RedPetroleum/openGBW/3D/Mignon MCI/Gabel.stl

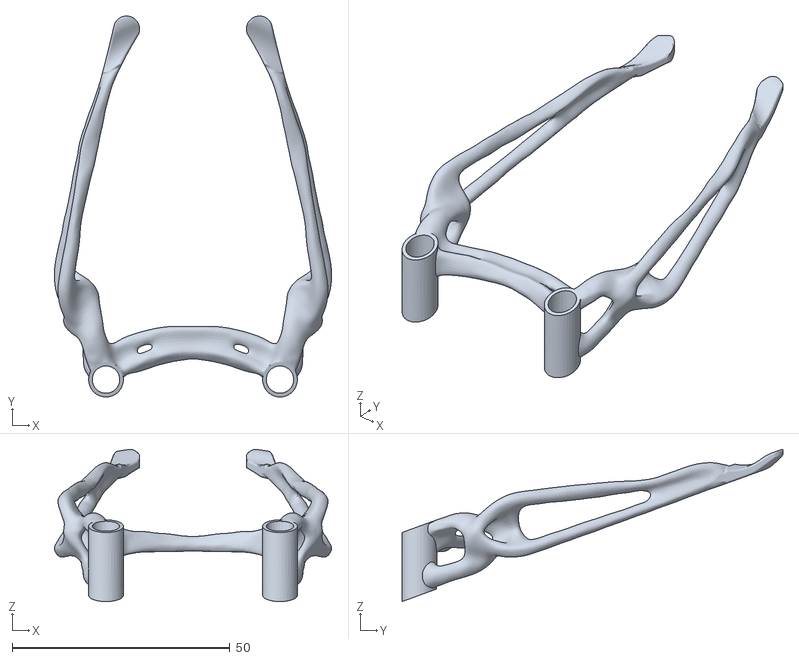
[picture p9: CAD file, 2026-09-14]
3D/Mignon MCI/Gabel.stl
63.7 x 87.6 x 35.0
