RedPetroleum/openGBW/3D/Mignon MCI/Waage_Display_Case.stl

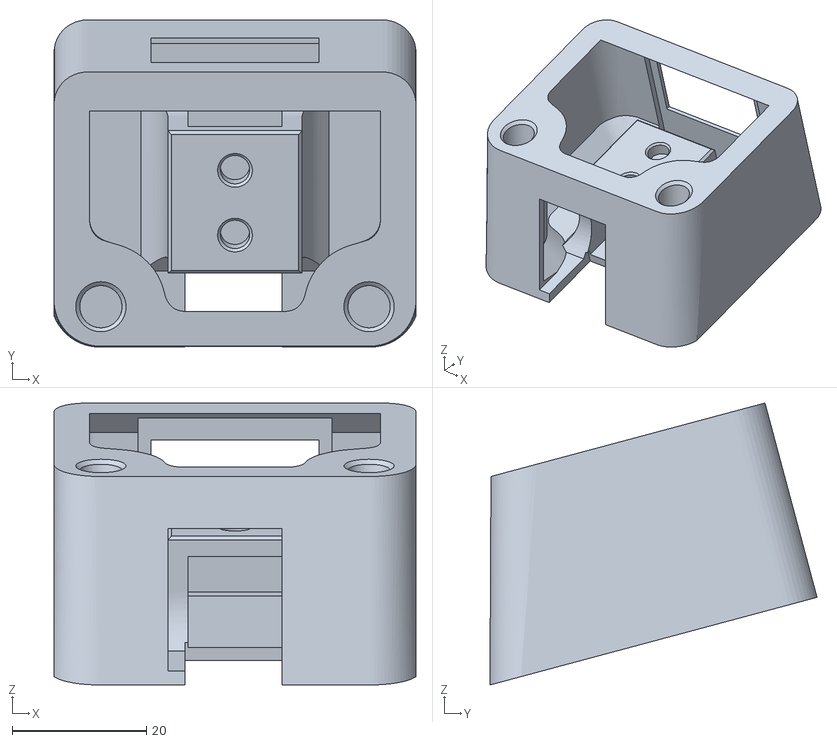
[picture p10: CAD file, 2026-09-14]
3D/Mignon MCI/Waage_Display_Case.stl
54.0 x 48.8 x 42.1
