RedPetroleum/openGBW/3D/Mignon MCI/Halter_oben.stl

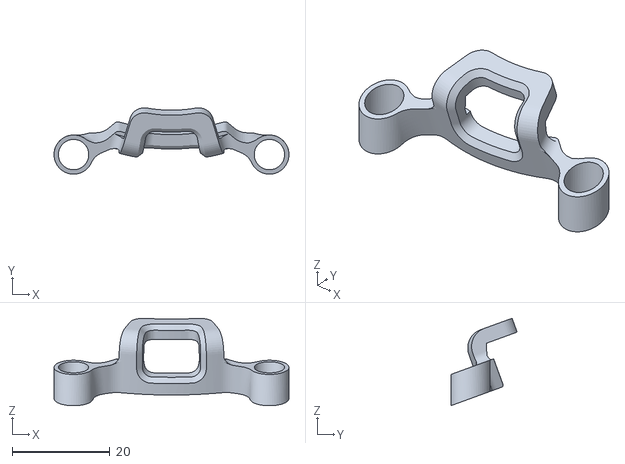
[picture p11: CAD file, 2026-09-14]
3D/Mignon MCI/Halter_oben.stl
48.0 x 13.5 x 17.9
