RedPetroleum/openGBW/3D/Mignon MCI/MCI_Stand.stl

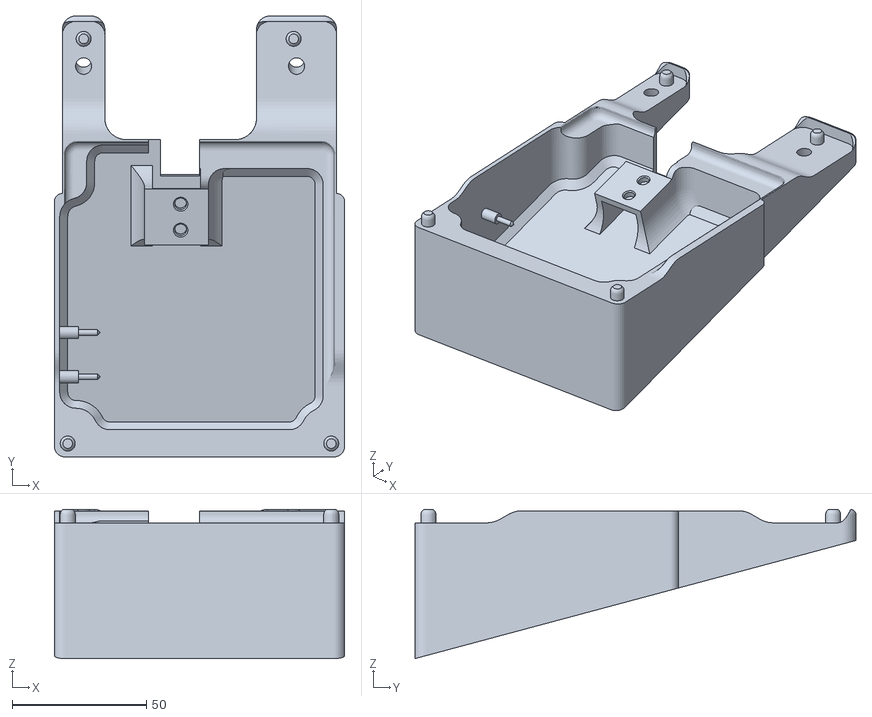
[picture p12: CAD file, 2026-09-14]
3D/Mignon MCI/MCI_Stand.stl
108.0 x 164.0 x 55.5
