RedPetroleum/openGBW/3D/Mignon MCI/Wood_plate.stl

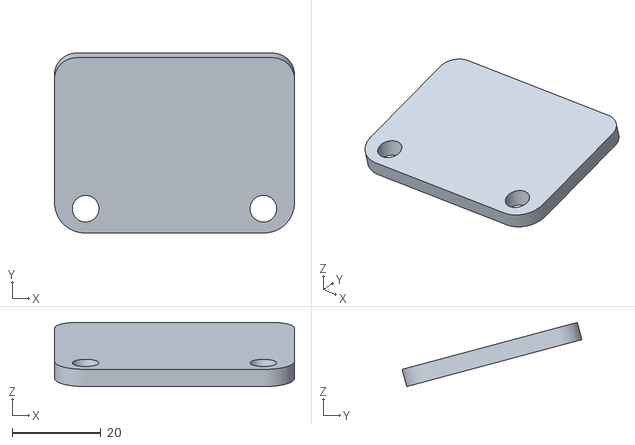
[picture p13: CAD file, 2026-09-14]
3D/Mignon MCI/Wood_plate.stl
54.0 x 40.5 x 14.4
