RedPetroleum/openGBW/src/games/doom_data.hpp

#pragma once

#include <stdint.h>

// Sprites, font and level of Doom, only included by doom.cpp
//
// Taken from doom-nano by daveruiz (https://github.com/daveruiz/doom-nano, commit 2346404):
// the AVR specific PROGMEM storage removed, the font and level macros renamed. In the level one of the two locked
// doors of the room with the key on the left is a normal door, otherwise the last key could be spent on it.
// Bitmaps have one bit per pixel, the highest bit is the leftmost pixel.

#define DOOM_LEVEL_WIDTH_BASE 6
#define DOOM_LEVEL_WIDTH (1 << DOOM_LEVEL_WIDTH_BASE)
#define DOOM_LEVEL_HEIGHT 57
#define DOOM_LEVEL_BYTES DOOM_LEVEL_WIDTH / 2 * DOOM_LEVEL_HEIGHT

#define FONT_BYTES_PER_ROW   24  // in bytes
#define FONT_ROWS  6
#define FONT_CHAR_MAP         " 0123456789ABCDEFGHIJKLMNOPQRSTUVWXYZ.,-_(){}[]#"
#define FONT_CHAR_WIDTH       4
#define FONT_CHAR_HEIGHT      6
const static uint8_t bmp_font[] = {
  0x00, 0x00, 0x00, 0x00, 0x00, 0x00, 0x00, 0x00, 0x00, 0x00, 0x00, 0x00, 0x00, 0x00, 0x00, 0x00, 0x00, 0x00, 0x00, 0x00, 0x00, 0x01, 0x80, 0x00,
  0x06, 0x26, 0x69, 0xf6, 0xf6, 0x66, 0xe6, 0xef, 0xf6, 0x92, 0x19, 0x89, 0x96, 0xe6, 0xe6, 0xe9, 0x99, 0x99, 0xf0, 0x00, 0x02, 0x41, 0x83, 0xcf,
  0x09, 0x29, 0x99, 0x88, 0x19, 0x99, 0x99, 0x98, 0x88, 0x92, 0x1a, 0x8f, 0xd9, 0x99, 0x98, 0x49, 0x99, 0x99, 0x10, 0x00, 0x04, 0x27, 0xe5, 0x6f,
  0x09, 0x22, 0x2f, 0xee, 0x16, 0x7f, 0xe8, 0x9e, 0xe8, 0xf2, 0x1c, 0x89, 0xb9, 0xe9, 0xe6, 0x49, 0x99, 0x66, 0x60, 0x06, 0x04, 0x27, 0xe7, 0xef,
  0x09, 0x24, 0x91, 0x19, 0x19, 0x19, 0x99, 0x98, 0x89, 0x92, 0x9a, 0x89, 0x99, 0x8b, 0x91, 0x49, 0x6f, 0x96, 0x80, 0x20, 0x04, 0x21, 0x87, 0xef,
  0x06, 0x7f, 0x61, 0xe6, 0x16, 0x69, 0xe6, 0xef, 0x86, 0x92, 0x69, 0xf9, 0x96, 0x87, 0x9e, 0x46, 0x69, 0x96, 0xf4, 0x40, 0xf2, 0x41, 0x80, 0xe0,
};

#define BMP_LOGO_WIDTH  72
#define BMP_LOGO_HEIGHT 47
const static uint8_t bmp_logo_bits[] = {
  0x00, 0x00, 0x00, 0x00, 0x00, 0x00, 0x00, 0x00, 0x00,
  0x40, 0x08, 0x00, 0x01, 0x04, 0x20, 0x08, 0x01, 0x12,
  0x00, 0x00, 0x10, 0x00, 0x00, 0x00, 0x40, 0x00, 0x00,
  0x40, 0x00, 0x80, 0x00, 0x50, 0x00, 0x28, 0x11, 0x02,
  0x40, 0x00, 0xa0, 0x00, 0x50, 0x00, 0x28, 0x0a, 0x02,
  0x60, 0x01, 0xa0, 0x00, 0x50, 0x00, 0x2c, 0x0a, 0x02,
  0x41, 0xe1, 0xb0, 0xf0, 0x50, 0x78, 0x28, 0x0a, 0x06,
  0x62, 0x20, 0xa1, 0xb8, 0x50, 0xc8, 0x2c, 0x04, 0x02,
  0x4a, 0x31, 0xb0, 0x88, 0xd0, 0x88, 0x28, 0x04, 0x06,
  0x62, 0x21, 0xa1, 0x88, 0x50, 0x88, 0x6c, 0x14, 0x02,
  0x43, 0x31, 0xb0, 0x8a, 0x52, 0x8a, 0x28, 0x80, 0x06,
  0x42, 0x31, 0xa8, 0xc8, 0xd0, 0x88, 0x2c, 0x42, 0x86,
  0x6b, 0x29, 0xa5, 0xa8, 0xd4, 0xea, 0xac, 0x50, 0x42,
  0x63, 0x65, 0xb4, 0xda, 0x52, 0xd9, 0x6c, 0x42, 0x26,
  0x53, 0xb1, 0xb1, 0xd8, 0xd4, 0xda, 0x6d, 0x48, 0x86,
  0x6b, 0x75, 0xb5, 0xda, 0x52, 0xfc, 0x6d, 0x6b, 0x56,
  0x6b, 0xa1, 0xb0, 0xfb, 0xda, 0xd9, 0x6c, 0x69, 0x46,
  0x53, 0xed, 0xbd, 0xfa, 0x76, 0xfa, 0xef, 0x6c, 0xb2,
  0x6f, 0xeb, 0xf4, 0xfd, 0xdd, 0xfd, 0x6c, 0xe7, 0x4e,
  0x77, 0xeb, 0xbf, 0xfe, 0xd6, 0xfb, 0xee, 0xf1, 0xe6,
  0x59, 0xef, 0xbc, 0xf2, 0xd6, 0xfb, 0xef, 0xf4, 0xf6,
  0xf3, 0xb7, 0xff, 0xfb, 0x5c, 0xff, 0xef, 0xd6, 0x7a,
  0x6b, 0xbf, 0xbe, 0x88, 0xd2, 0xdf, 0xef, 0xdc, 0xd6,
  0x4b, 0x7f, 0xff, 0xca, 0x70, 0x9f, 0xef, 0xde, 0xce,
  0x4b, 0xdf, 0xbf, 0xeb, 0x76, 0xff, 0xef, 0xdf, 0xd6,
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
  0x01, 0x01,
  0xaa, 0xaa,
  0x44, 0x44,
  0xaa, 0xaa,
  0x55, 0x55,
  0xaa, 0xaa,
  0x44, 0x44,
  0xaa, 0xaa,
  0x15, 0x55,
  0xaa, 0xaa,
  0x55, 0x55,
  0xaa, 0xaa,
  0x55, 0x55,
  0xbb, 0xbb,
  0x55, 0x55,
  0xaa, 0xea,
  0x55, 0x55,
  0xbb, 0xbb,
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
};

/*
  Based on E1M1 from Wolfenstein 3D

  ################################################################
  #############################...........########################
  ######....###################........E..########################
  ######....########..........#...........#...####################
  ######.....#######..........L.....E.......M.####################
  ######.....#######..........#...........#...####################
  ##################...########...........########################
  ######.........###...########...........########################
  ######.........###...#############D#############################
  ######.........#......E##########...############################
  ######....E....D...E...##########...############################
  ######.........#.......##########...############################
  ######....E....##################...############################
  #...##.........##################...############################
  #.K.######D######################...############################
  #...#####...###############...#E.....K##########################
  ##D######...###############..####...############################
  #...#####...###############..####...############################
  #...#...#...###############..####...############################
  #...D...#...#####################...############################
  #...#...#...#####################...############################
  #...######D#######################L#############################
  #.E.##.........#################.....#################........##
  #...##.........############...............############........##
  #...##...E.....############...............############........##
  #....#.........############...E.......E....#.........#........##
  #....D....K....############................D....E....D....E...##
  #....#.........############................#.........#........##
  #...##.....E...############...............####....####........##
  #...##.........############...............#####..#####.....M..##
  #...##.........#################.....##########..#####........##
  #...######L#######################D############..###############
  #...#####...#####################...###########..###############
  #E.E#####...#####################...###########..###############
  #...#...#...#####################.E.###########..###############
  #...D.M.#...#####################...###########..###############
  #...#...#...#####################...###########..###.#.#.#.#####
  #...#####...#####################...###########...#.........####
  #...#####...#####################...###########...D....E..K.####
  #................##......########...###########...#.........####
  #....E........E...L...E...X######...################.#.#.#.#####
  #................##......########...############################
  #################################...############################
  #############..#..#..#############L#############################
  ###########....#..#.########....#...#....#######################
  #############.....##########.P..D...D....#######################
  ############################....#...#....#######################
  ##############..#################...############################
  ##############..############....#...#....#######################
  ############################....D...D....#######################
  ############################....#...#....#######################
  #################################...############################
  ############################.............#######################
  ############################..........EK.#######################
  ############################.............#######################
  ################################################################
*/

/*
   Same map above built from some regexp replacements using the legend above.
   Using this way lets me use only 4 bit to store each block
*/
const static uint8_t level1[DOOM_LEVEL_BYTES] = {
  0xFF, 0xFF, 0xFF, 0xFF, 0xFF, 0xFF, 0xFF, 0xFF, 0xFF, 0xFF, 0xFF, 0xFF, 0xFF, 0xFF, 0xFF, 0xFF, 0xFF, 0xFF, 0xFF, 0xFF, 0xFF, 0xFF, 0xFF, 0xFF, 0xFF, 0xFF, 0xFF, 0xFF, 0xFF, 0xFF, 0xFF, 0xFF, 
  0xFF, 0xFF, 0xFF, 0xFF, 0xFF, 0xFF, 0xFF, 0xFF, 0xFF, 0xFF, 0xFF, 0xFF, 0xFF, 0xFF, 0xFF, 0xFF, 0xFF, 0xFF, 0xFF, 0xFF, 0xFF, 0xFF, 0xFF, 0xFF, 0xFF, 0xFF, 0xFF, 0xFF, 0xFF, 0xFF, 0xFF, 0xFF, 
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
  0xF0, 0x00, 0xFF, 0xFF, 0xF0, 0x00, 0xFF, 0xFF, 0xFF, 0xFF, 0xFF, 0xFF, 0xFF, 0xFF, 0xFF, 0xFF, 0xF0, 0x00, 0xFF, 0xFF, 0xFF, 0xFF, 0xFF, 0xF0, 0x00, 0x40, 0x00, 0x02, 0x00, 0x90, 0xFF, 0xFF, 
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
};
