RedPetroleum/openGBW/(commit log)

2026-09-13 Eigenen lokalen Stand übernehmen
    Basis: becc51d mit angepassten Werten in config.hpp (Tassengewicht,
    Scale-Faktor, Dosis, Grinder-Pin), deaktiviertem Mahlfehler-Abbruch
    und Versionsanzeige v5.
    [openGBW - Base v7.3mf, openGBW - DosingCupPlate v13.3mf, openGBW - LoadCellHolder - Long v4.3mf, openGBW - LoadCellHolder - Short v1.3mf]
2026-09-13 Kalibrierfaktor in Infos anzeigen und manuell verstellbar machen
    - Neuer Menüpunkt "Scale Factor" mit Live-Gewicht, Speichern per Klick
    - Infoseite zeigt Scale Factor und wird direkt beim Öffnen angezeigt
    - Calibrate nutzt den aktuellen Faktor statt 1.0 und bricht ohne Gewicht ab
2026-09-13 Mahlvorgang vor vorzeitigem Abbruch schützen
    - Displaytimer setzt einen laufenden Mahlvorgang nicht mehr zurück
    - Mühle stoppt nicht mehr bei einzelnen Messausreißern (Vibration)
    [config.hpp, scale.cpp]
2026-09-13 Scale-Faktor-Standard auf 1000, Drehrichtung des Encoders umgekehrt
    Sleep Timer berücksichtigt jetzt ebenfalls die Drehrichtung.
2026-09-13 Set-Gewicht wie Messgewicht zentrieren, Shot Count Reset auf 299
    [config.hpp, display.cpp, rotary.cpp, scale.cpp]
2026-09-13 Zweiten Cup hinzufügen (Standard 76,3 g)
    - Eigener Menüpunkt "Cup Weight 2", gespeichert unter cup2
    - Mahlvorgang startet, wenn einer der beiden Cups erkannt wird
    - Infoseite zeigt beide Cup-Gewichte, Reset setzt beide zurück
    [config.hpp, display.cpp, rotary.cpp, scale.cpp]
2026-09-13 Menü überarbeiten, Weight History im Debug-Menü umsetzen
    - Exit als erster Menüpunkt (Haupt- und Debug-Menü), Calibrate entfernt
    - Cup-Menüs lassen sich durch Drehen ohne Speichern verlassen
    - Scale Mode zeigt "GBW (default)", Grinding Mode Standard ist Continuous
    - Weight History zeigt Verlaufsgrafik, Debug-Menüpunkte nicht mehr fett
2026-09-13 Weight Chart umbenennen, neue Weight History mit Dauer und Offset
    - Bisherige Verlaufsgrafik heißt jetzt Weight Chart
    - Weight History zeigt Shot-Nummer, Mahldauer und verwendeten Offset
    der letzten 10 Mahlvorgänge, dauerhaft gespeichert, per Drehen scrollbar
2026-09-13 Mahlfehler per Knopfdruck verlassen, Abbruchgrund anzeigen
    - Fehlerzustand wird nur noch per Knopfdruck verlassen (vorher ab 150 g,
    was mit schwerem Cup sofort erfüllt war und eine Neustart-Schleife auslöste)
    - Display und serielle Konsole zeigen den Abbruchgrund
    - "No progress" wird erst 10 s nach Mahlbeginn geprüft
    - Scale error bricht sofort ab, Displaytimer hebt Fehlerzustand nicht auf
    [config.hpp, display.cpp, rotary.cpp, scale.cpp]
2026-09-13 Spiel "Comet Blaster" im Menü hinzufügen
    Raumschiff mit dem Drehknopf steuern, Laser durch Drücken der Waage
    (stärker und breiter je mehr Gewicht, verbraucht Energie). Kometen
    müssen mittig getroffen werden und bringen Punkte und Energie,
    Herzen geben Extra-Leben. Bestwert wird gespeichert.
    Während des Spiels liefert die Waage ungefilterte Einzelmessungen,
    damit der Laser ohne Verzögerung reagiert. Ein konstanter Versatz
    ohne Drücken wird automatisch nachtariert.
2026-09-13 Games-Menü mit Curve Tracer, Sleep Timer korrigieren, README aktualisieren
    - Menüpunkt "Games" mit Untermenü, Comet Blaster und neues Spiel Curve Tracer
    (Linie mit dem Druck auf der Waage nachfahren)
    - Gemeinsamer Spiele-Kern: Eingaben, Frame-Takt, Nullpunkt, Pause/Game Over, Bestwerte
    - Sleep Timer wirkt jetzt überall und wird beim Start geladen; Waage antippen,
    Drehen oder Klicken weckt das Display, ohne etwas zu verstellen
    - README: zwei Cups, Scale-Factor-Kalibrierung, Abbruchgründe, Menüs, Spiele
    [config.hpp, display.cpp, display.hpp, game.cpp, game_comet_blaster.cpp, game_common.hpp, game_curve_tracer.cpp, rotary.cpp]
2026-09-13 README: Differences und Herkunft der Forks neu aufbauen, veraltete Abschnitte entfernen
2026-09-13 README: Hardware der Mignon MCI beschreiben (3,0-V-Versorgung, Ansteuerung per Transistor)
2026-09-13 README: Differences kürzer zusammenfassen, manuellen Modus der MCI beschreiben
    - Differences als kurze Liste statt Unterabschnitte
    - Hinweis, dass openGBW nur im manuellen Modus der MCI funktioniert und die
    Mühle weiterhin manuell oder mit Timer genutzt werden kann
    - Getting started: an der MCI Grinding Mode continuous und manuellen Modus verwenden
2026-09-14 Spiel "Doom Nano" im Games-Menü hinzufügen
    Raycaster-Shooter auf Basis von daveruiz/doom-nano (Engine, Gegner, Sprites,
    Level) mit den Türen aus ZelTroN-2k3/Doom-Nano-ESP32, umgebaut auf das
    Frame-Gerüst der Spiele: Waage drücken läuft, Knopf dreht, Klick schießt,
    Waage hochziehen lädt nach, Knopf halten pausiert. gamePressedWeight()
    unterstützt dafür optional Zug an der Waage.
2026-09-14 Spiele in den Ordner src/games verschieben
    game.cpp heißt jetzt games.cpp und gehört zu include/games.hpp (Schnittstelle
    für rotary und display). Die internen Header der Spiele (common.hpp,
    doom_data.hpp) liegen neben den Spielen, das game_-Präfix entfällt.
2026-09-14 Doom: Namen kürzen, nach dem Logo direkt ins Level
    Das Spiel heißt im Menü und in der README nur noch "Doom". Der Countdown-
    Bildschirm mit der Steuerung entfällt, nach dem Logo blendet das Level ein.
2026-09-14 Doom: volle Geschwindigkeit vorwärts und rückwärts schon bei 60 g
2026-09-14 Doom: HUD mit Herz, Schlüssel-Symbolen und Fadenkreuz
    Leben links mit Herz, jeder Schlüssel als eigenes Symbol in der Mitte,
    Munition rechts mit Fadenkreuz. Zahlen in u8g2_font_5x7 wie in den anderen
    Spielen, die Symbole sind mittig zu den Ziffern ausgerichtet.
2026-09-14 Doom: größeres Schlüssel-Symbol mit zwei Zähnen und Anzahl daneben
2026-09-14 Doom: Karte im Pause-Menü
    Das Pause-Menü hat jetzt Continue, Map und Exit. Die Karte zeigt wie die
    Automap in Doom nur den erkundeten Teil des Levels (ein Pixel pro Feld):
    Wände, Türen (verschlossene blinken langsam), den Ausgang (blinkt schnell)
    und den Spieler mit Blickrichtung, rechts daneben Kills und Zeit.
2026-09-14 3D-Modelle für die Mignon MCI hinzufügen, Bild in der README
    [Gabel.stl, Halter_oben.stl, MCI_Stand.stl, Waage_Display_Case.stl, Wood_plate.stl]
2026-09-14 README: Stückliste, Verkabelung und Anschluss an die Basis beschreiben
    Hardware-Abschnitt mit Unterüberschriften für Stückliste und Verkabelung,
    Anschluss der Elektronik in der Basis ergänzt. Getting started gekürzt,
    Abschnitt zu den Abbrüchen beim Mahlen entfernt.
2026-09-14 Display-Simulator für Screenshots des Displays
    sim/ kompiliert den Display-, Menü- und Spielcode mit U8g2 auf dem Computer
    gegen kleine Stubs für Arduino, Waage, Preferences und Drehgeber und speichert
    das Display als PNG. Knopf, Drehgeber und Waage werden per Skript gesteuert,
    screenshots.txt erzeugt alle Screens (make screenshots).
    Der Rumpf der Schleife in updateDisplay steckt dafür in refreshDisplay(),
    das Verhalten der Firmware bleibt gleich.
2026-09-14 README: Screenshots, Titel und Einleitung mit Spielen
    Screenshots von Hauptanzeige, Mahlen und den drei Spielen, erzeugt mit dem
    Display-Simulator (make readme-screenshots). Titel und erster Satz nennen
    jetzt die Spiele, die 1kg Load Cell und den zweiten Cup oder Siebträger.
2026-09-14 README: Adern zur MCI als power, ground and signal bezeichnen
2026-09-18 Waage: alles bis 30 g automatisch wegtarieren, wenn der Wert ruhig ist
2026-09-18 Tasse und Dosis erst messen, wenn die letzten 3 Werte auf 0,1 g ruhig sind
2026-09-18 Weight History: Ziel, Ist und Abweichung auf einer zweiten Spaltenseite
    Die Tabelle ist zu breit für das Display, daher blättert ein Druck auf die
    Waage nach rechts und ein Zug nach oben zurück.
2026-09-18 Offset nur noch zwischen 0 und -10 g und um 70% der letzten Abweichung nachführen
    Der Offset summiert sich über die Mahlgänge, eine Teilkorrektur erreicht also
    weiterhin den richtigen Wert, ein einzelner Messausreißer verschiebt ihn aber
    nicht mehr voll. Statt den gelernten Wert bei einem unplausiblen Ergebnis auf
    den Default zurückzusetzen, wird er nur noch begrenzt.
2026-09-18 Curve Tracer: Schwierigkeit doppelt so schnell, Höchsttempo 90 statt 60 px/s
2026-09-18 Grinding-Screen: Fortschrittsbalken, der nie ganz voll wird
    Die Füllung liegt ohne Abstand am Rahmen und bleibt ein Pixel vor dem Ende
    stehen, denn die Dosis gilt erst nach der Ruhe-Prüfung als erreicht.
2026-09-18 Boot-Screen: drehende Espressotasse als Drahtgittermodell über einem Ladebalken
    Ersetzt "Hello" und "Initializing...": die Tasse wird pro Frame gedreht,
    gekippt und perspektivisch projiziert, der Balken füllt sich über die Zeit,
    die Tarieren und erste Mittelung brauchen. Der Simulator zeigt den Screen
    mit dem neuen Kommando "boot <ms>".
2026-09-18 Curve Tracer: Schwierigkeitsanstieg und Höchsttempo nur halb so stark anheben
2026-09-18 Tarieren verwerfen, wenn die Messwerte zu weit auseinanderliegen
    Eine während der zwei Sekunden aufgesetzte Tasse wäre sonst zur Hälfte im
    neuen Nullpunkt gelandet. Außerdem blättert die Weight History schon bei
    leichtem Druck auf die Waage weiter.
2026-09-18 Erst nach verifiziertem Gewicht auf "finished" wechseln
    Die Mühle stoppt unverändert beim Zielgewicht, danach zeigt das Display
    "Verifying", bis die Messwerte ruhig sind - erst dann gilt die Dosis als
    erreicht und wird verbucht.
2026-09-18 Weight Chart zeigt Rohdaten: ein Messwert pro Pixelspalte
    Während der Chart offen ist, liefert der Scale-Task ungefilterte
    Einzelmessungen. Sie werden nicht mehr über die Breite gestreckt und nicht
    mehr zu einer Linie verbunden, der Puffer fasst dafür 128 statt 100 Werte.
    Oben links steht das aktuelle Gewicht mit zwei Nachkommastellen, rechts die
    Spanne und die Dauer des Graphen.
2026-09-18 Boot-Screen erst verlassen, wenn der Balken voll ist
    Nach dem Abbruch einer Tarierung lief der Messteil bisher weiter und beendete
    den Boot-Screen, obwohl noch gar nicht tariert war.
2026-09-19 Mahlvorgänge über USB mitschneiden und die Filter darauf entwickeln
    Die Firmware schickt während eines Mahlvorgangs jede einzelne Messung des
    HX711 über die serielle Verbindung: ungefiltert, ungemittelt und mit den
    vollen 10 Hz des Chips. Aufgezeichnet wird ab der Cup-Erkennung bis eine
    Sekunde nach der verifizierten Dose, damit auch das Beruhigen der Waage im
    Log steht.
    Der Sampler holt die Messungen dafür einzeln statt über get_units(n), das
    sie in der Library mittelt. Ihr Mittelwert ist derselbe Wert wie vorher, die
    Regelung verhält sich also unverändert; die Bündelzahl steckt jetzt in
    SCALE_READINGS_PER_UPDATE.
    Dazu drei Werkzeuge: grindlog.py schneidet mit und schreibt pro Ma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
2026-09-19 Filter v01 in der Firmware, der alte bleibt daneben stehen
    Für jede Messung eine Ausgleichsgerade über das längste Fenster der letzten
    Messwerte, auf das sie noch innerhalb von 0,15 g passt, abgelesen am neuesten
    Wert, und ein Kalman dahinter. Wo das Gewicht ruht, passt ein langes Fenster
    und der Wert ist ruhig; wo Kaffee klumpenweise fällt, nur ein kurzes und er
    folgt sofort. Anders als ein Mittelwert hinkt eine Gerade einem steigenden
    Gewicht auch bei langem Fenster nicht hinterher. Ein Unterschied ab 1 g ist
    ein Sprung: er wird übernommen und das Fenster geleert.
    Damit liefert die Waage zehn statt zwei Gewichte pro Sekunde. Alles, was
    Messwerte zählt statt Zeit, zieht mit: STEADY_R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
2026-09-19 Mitschneiden auch ohne Mahlvorgang
    Ein "r" auf der seriellen Verbindung startet eine Aufnahme, die läuft bis ein
    "s" kommt - unabhängig davon, was die Waage gerade tut. Damit lässt sich das
    Rauschen der ruhenden Waage aufzeichnen, oder von Hand aufgelegte Gewichte,
    oder sonst irgendetwas, mit dem ein Filter zurechtkommen muss.
    Ein Mahlvorgang, der während einer solchen Aufnahme beginnt, unterbricht sie
    nicht, sondern hinterlässt nur seine Marker darin. Der Kopf der Aufnahme sagt
    mit kind=grind oder kind=manual, worum es sich handelt.
    Die Befehle liest die Statusaufgabe, die ohnehin die einzige ist, die dem
    Sampler Marker übergeben darf. Auf der Rechnerseite macht das
    "grindlog.py --r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
    [config.hpp, grindlog.cpp, grindlog.hpp, grindlog.py, plotgrind.py, scale.cpp]
2026-09-19 Aufnahme ohne Mahlvorgang über Tasten statt über ein Flag
    Während grindlog.py mithört, starten und beenden "r" und "s" eine Aufnahme,
    "q" beendet das Programm. Die Tasten werden einzeln gelesen, ohne Enter; wo
    das nicht geht, weil die Eingabe kein Terminal ist, bleibt --record für
    Skripte.
    Die serielle Seite liest jetzt Bytes in einen Puffer und zerlegt selbst in
    Zeilen, statt readline zu benutzen: select() weckt beide Seiten, und ein
    angefangener Puffer wird nicht mehr als halbe Zeile verarbeitet.
2026-09-19 Rückmeldung auf jeden Tastendruck im Logger
    Vorher blieb der Bildschirm nach einem "r" stumm, bis die Waage antwortete.
    Antwortete sie nicht - falscher Port, oder eine Firmware ohne das Grind-Log -
    war nicht zu unterscheiden, ob die Taste überhaupt angekommen war.
    Jetzt quittiert jede Taste sofort, auch eine unbekannte, und wenn nach zwei
    Sekunden keine Antwort auf das "r" da ist oder nach fünf Sekunden überhaupt
    nichts vom Port kommt, sagt das Programm das mit dem Portnamen dazu.
    [grindlog.py]
2026-09-19 Filter v02 in der Firmware, v01 bleibt daneben stehen
    v02 ist das gleitende Mittel der letzten fünf Messwerte durch den Kalman des
    alten Filters: dieselbe Menge Mittelung und dieselben Kalman-Werte wie vorher,
    aber gleitend statt blockweise, also ein Gewicht pro Messung statt pro fünfter.
    Eine eigene Flachheitserkennung hat er nicht, die Anzeige-Hysterese bleibt bei
    ihm deshalb auf der weichen Stufe.
    Aus dem Schalter FILTER_V01 wird damit eine Auswahl: FILTER ist FILTER_OLD,
    FILTER_V01 oder FILTER_V02, und FILTER_FAST sagt, ob ein Gewicht pro Messung
    herauskommt - daran hängen STEADY_READINGS und MAX_PLAUSIBLE_WEIGHT_JUMP.
    Aktiv ist v02, alle drei Einstellungen bauen fehlerfrei.
    Co-Auth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
    [config.hpp, scale.cpp]
2026-09-19 Drei Erkennungskurven von v01 im unteren Diagramm
    Statt der einen trainierten Formel zeigt das untere Diagramm jetzt drei
    Kurven, alle auf den Rohwerten und alle zwischen 0 und 1:
    flach_v01 aus der Spannweite - zehn Messwerte innerhalb 0,7 g sind 1, fünf
    innerhalb 0,7 g sind 0,8, dazwischen wird über die Anzahl interpoliert; fünf
    innerhalb 1,2 g sind 0,5, dazwischen über die Gramm. Breiter ist 0.
    aufsetzen_v01 ist 1, wenn zwei aufeinanderfolgende Messwerte mehr als 1 g
    auseinanderliegen.
    mahlen_v01 nimmt die Steigung einer Geraden über die letzten Messwerte: je
    länger ein Fenster eine Rate im Bereich zeigt, desto höher, zwanzig Messwerte
    geben 1 und fünf geben 0,5. Zwischen Kern-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
2026-09-19 Drittes Diagramm mit den gemittelten Erkennungen, Einfärbung raus
    aufsetzen_v01 löst erst ab 1,5 g aus. In den drei Mahl-Logs bleibt damit nur
    noch ein Auslöser übrig statt sechs - die Klumpen, die vorher mitgezählt
    wurden, liegen zwischen 1,0 und 1,5 g.
    Die Einfärbung "flach erkannt" hinter den Kurven ist ausgeblendet, damit auch
    die Option --flat, die nur sie gesteuert hat; flat_shading() bleibt im Modul.
    Darunter ein drittes Diagramm mit denselben drei Kurven, gemittelt über die
    letzten 15 Messungen. Alle sechs sind leicht unterfüllt, sonst sind drei
    Kurven, die sich die 0 und die 1 teilen, nicht auseinanderzuhalten.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
2026-09-19 Drittes Diagramm zeigt die Ableitung statt des Mittels selbst
    Der gleitende Durchschnitt über 15 Messungen wird nicht mehr eigens
    gezeichnet, nur noch wie schnell er sich ändert, in Gramm pro Sekunde.
    Drei Diagramme: Gewicht mit den Filtern, die drei Erkennungen, die Ableitung.
2026-09-19 Ableitung bei 10 g/s gedeckelt, Mahlbereich zwei g/s weiter
    Das dritte Diagramm zeigt höchstens 10 g/s nach oben und -10 nach unten. Eine
    aufgesetzte Tasse erzeugt hunderte g/s und hat bisher alles andere zu einer
    Linie flachgedrückt.
    Der Mahlbereich von mahlen_v01 reicht oben zwei g/s weiter: Kern jetzt 0,5 bis
    5,5 g/s, grob 0,4 bis 6,0.
2026-09-19 flach_v01 erst nach 20 Messungen auf 1, Mahl-Sperre bei ruhiger Waage
    Die Obergrenze von flach_v01 liegt bei 20 statt 10 Messungen: erst wenn so
    viele innerhalb von 0,7 g liegen, ist der Wert 1. Die Umsetzung entsprach
    der Regel schon vorher, nur mit der ursprünglich genannten 10.
    mahlen_v01 ist 0, wenn die Ableitung des gleitenden Durchschnitts unter
    1 g/s liegt und der Wert es nicht über 0,6 geschafft hat. Damit fallen die
    0,5-Ausschläge weg, die das Rauschen der ruhenden Waage erzeugt hat.
2026-09-19 flach_v01 bekommt ein Veto durch die Änderungsrate
    Die Ableitung des gleitenden Durchschnitts überstimmt die Spannweite: ab
    1 g/s ist nichts mehr flach, egal wie eng die Messwerte beieinanderliegen,
    und zwischen 0,5 und 1 g/s wird der Wert linear dorthin ausgeblendet. Der
    Betrag zählt, eine fallende Waage steht genauso wenig wie eine steigende.
2026-09-19 Drittes Diagramm: eine Antwort aus den drei Erkennungen
    flach_v02, aufsetzen_v02 und mahlen_v02 sind das aufgelöste Ergebnis der drei
    v01-Kurven: höchstens eines davon ist 1, die Summe also immer 0 oder 1.
    Gewinnen kann nur, wer selbst auf 1 steht - oder auf 0,8, wenn die anderen
    beiden bei null liegen. Stehen Mahlen und Aufsetzen gleichzeitig auf 1, gewinnt
    Mahlen; ein Klumpen, der beim Mahlen landet, ist immer noch Mahlen. Jeder
    andere Gleichstand ist keine Antwort, dann sind alle drei 0.
    Die Ableitung rutscht damit auf das vierte Diagramm.
2026-09-19 Filter v03: v01, bei flach_v02 stattdessen v02
    v03 nimmt für jede Messung den Wert von v01, außer wo die Antwort aus dem
    dritten Diagramm sagt, dass das Gewicht flach liegt - dort den von v02.
    Gemischt wird vor der Hysterese, damit der angezeigte Wert einmal gerundet
    wird und nicht zweimal.
    Dafür wandert die Berechnung der Erkennungen vor die Filterlinien, und
    average_kalman() ist in die Kette und die Hysterese darum aufgeteilt.
    In Shot 327 folgt v03 in 62 von 167 Messungen dem v02 und sonst dem v01.
    [plotgrind.py]
2026-09-19 v03 neu: Wert immer von v01, v02 stimmt nur der Hysterese zu
    v03 nimmt jetzt immer den Wert von v01. Ein einzelner 0,1-Schritt der Anzeige
    braucht zusätzlich zu den bisherigen Bedingungen, dass flach_v01 auf 1 steht
    und dass v02 auf demselben Schritt landen würde. Ein Unterschied von zwei
    Schritten oder mehr ist davon unberührt, ein steigendes Gewicht wird also in
    0,2-Schritten verfolgt statt in 0,1er.
    Dazu: wird zehn Messungen lang ein Wert innerhalb von 0,2 g um null angezeigt,
    zeigt v03 glatt 0,0. Nur die Anzeige, der Wert dahinter bleibt unangetastet -
    tariert wird nichts.
    In der tarierten Handaufnahme zeigt v03 damit in 56 von 134 Messungen null,
    v01 in 42 und dazwischen springend.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
2026-09-19 v03: der Schritt wird immer gemacht, nur die Quelle wechselt
    Falsch verstanden hatte ich, dass die vier Bedingungen einen 0,1-Schritt
    verhindern. Sie tun das nicht: die Anzeige folgt v01 mit der gewöhnlichen
    Hysterese, auch beim Mahlen in 0,1-Schritten. Nur wo ein einzelner Schritt
    fällig ist, die bisherigen Bedingungen greifen, flach_v01 auf 1 steht und v02
    auf demselben Schritt landen würde, kommt der Wert von v02 statt von v01.
    Die Null-Regel bleibt unverändert.
2026-09-19 v03: bei flach_v01 = 1 braucht der Schritt die Zustimmung von v02
    Bislang wurde der Schritt in jedem Fall gemacht und die Zustimmung entschied
    nur, wessen Wert dahintersteht - was nichts änderte, weil beide auf demselben
    Schritt landen mussten. Am Ende von Shot 326 ging v03 deshalb auf 94,5, obwohl
    v02 bei 94,4 blieb.
    Jetzt: solange flach_v01 unter 1 liegt, folgt die Anzeige v01 in 0,1-Schritten
    wie bisher. Steht flach_v01 auf 1, braucht ein einzelner Schritt zusätzlich,
    dass v02 dort ankommt; sonst bleibt die Anzeige stehen. Die Bestätigungszahl
    läuft dabei weiter, damit der Schritt sofort erfolgt, sobald v02 nachkommt.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
2026-09-19 v03 prüft flach_v02 statt flach_v01
    Die Zustimmung von v02 wird jetzt dort verlangt, wo die aufgelöste Antwort des
    dritten Diagramms auf flach steht, nicht schon dort, wo der rohe Detektor eine
    1 meldet. v02 wird damit nur gefragt, wenn sich die drei Erkennungen einig
    sind, dass sonst nichts los ist.
2026-09-19 Filter v03 in der Firmware
    Die drei Erkennungen von v01 und die Anzeige von v03 sind portiert: ein Ring
    der letzten 20 Messwerte speist Spannweite und Ausgleichsgerade, daraus
    entstehen flach, aufsetzen und mahlen, und deren Auflösung sagt, ob die Waage
    flach liegt. Das Gewicht kommt von v01, v02 läuft daneben mit und hat nur in
    der Anzeige ein Wort mitzureden.
    Die Ableitung, die flach und mahlen brauchen, wird auf der Waage rückwärts
    über zwei Messungen genommen - zentriert ginge nur mit einem Blick in die
    Zukunft. Das Diagramm rechnet jetzt genauso; auf den Aufzeichnungen liefern
    beide Varianten in jeder einzelnen Messung dasselbe v02-Ergebnis.
    Geprüft mit einem Prüfstand, der den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
    [config.hpp, plotgrind.py, scale.cpp]
2026-09-19 Kleine negative Werte am Nullpunkt halten
    Nimmt man ein schweres Gewicht herunter, schwingt die Waage kurz ins
    Negative. Die Anzeige von v03 zeigt einen negativen Wert daher erst bei
    -0,5 g oder nach fünf negativen Messungen in Folge; einmal freigegeben
    bleibt er stehen, bis der Wert wieder bei null ist. Nur die Anzeige, das
    Gewicht dahinter bleibt unberührt. tools/plotgrind.py rechnet dasselbe.
2026-09-19 Tare ohne Einfrieren: die Messschleife sammelt seine Messungen
    tareScale() las seine TARE_MEASURES Messungen am Stück und hielt dabei
    die Messschleife knapp zwei Sekunden an: nichts gemessen, nichts
    veröffentlicht, nichts geloggt, Anzeige steht. In den Logs sieht man das
    als Lücke von genau 2,02 s, und weil der Auto-Tare auf der leeren Waage
    alle fünf Sekunden wieder darf, hakt die Anzeige im Leerlauf regelmäßig.
    Jetzt holt die Messschleife die Tare-Messungen eine pro Durchlauf
    (tareTake()), und das Gewicht läuft währenddessen mit dem alten
    Nullpunkt weiter. Solange die Waage überhaupt keinen Nullpunkt hat,
    wird wie bisher nichts veröffentlicht. Fällt der HX711 mitten im Bündel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
2026-09-19 Tasse und Dosis schneller erkennen
    Die Tassenerkennung nimmt jetzt drei Paare aus Messungen und erlaubter
    Spanne, eines davon genügt: die alten 15 innerhalb 0,1 g, neu 5
    innerhalb 0,6 g und 10 innerhalb 0,7 g. Geprüft wird die Nähe zum
    Tassengewicht über genau die Messungen, die auch über die Ruhe
    entscheiden, statt über ein festes 1-s-Fenster. Eine ruhige Tasse steht
    damit nach 0,5 s statt nach 1,5 s fest.
    Weil die Erkennung jetzt früher greift, kommt cupWeightEmpty aus den
    letzten 5 Messungen: die Mittelung über eine ganze Sekunde hätte in das
    Aufsetzen zurückgereicht und das Leergewicht der Tasse um Dutzende
    Gramm verfehlt.
    Nach dem Mahlen ersetzt dieselbe Regel das Zeitfenste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
2026-09-19 Geraden durch Messbereiche legen
    plotgrind.py bekommt --fit und --level, die eine Ausgleichsgerade
    beziehungsweise eine Horizontale durch einen Zeitbereich legen und über
    die ganze Breite durchziehen. plotfits.py stellt mehrere Mahlvorgänge
    mit denselben drei Geraden untereinander.
2026-09-19 Grinder nach Massenstrom stoppen statt nach Offset
    Durch die Messwerte der letzten vier Sekunden läuft eine Ausgleichsgerade,
    und beide Zahlen der Abschaltentscheidung kommen von ihr: x ist ihr Wert
    im Jetzt, der Massenstrom ihre Steigung. In den ersten fünf Sekunden ist
    die Gerade noch zu kurz für eine belastbare Steigung, dort ist der
    Massenstrom x / (t - 0,8s) mit der Totzeit, bis die ersten Körner auf der
    Waage ankommen. Abgeschaltet wird, sobald x + ms * totzeit_ende das
    Zielgewicht erreicht; danach läuft die Totzeit ab, und erst die Messwerte
    von da an zählen für die Verifizierung.
    Der Offset in Gramm entfällt, stattdessen kalibriert sich die Totzeit nach
    jedem Mahlvorgang: wa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
2026-09-19 Auf die Millisekunde abschalten statt auf den Messwert
    Messwerte kommen zehnmal pro Sekunde, die Statusschleife läuft alle 50 ms:
    zusammen landete die Abschaltung 0 bis 153 ms nach dem rechnerischen
    Zeitpunkt, bei 2 g/s also bis zu 0,3 g zu spät. Der Mittelwert davon wurde
    von der Totzeitkalibrierung als längere Totzeit gelernt, die Streuung aber
    blieb als Rauschen von Vorgang zu Vorgang stehen.
    Jetzt wird die Gerade auf ihren Schnittpunkt mit dem Ziel extrapoliert:
    fehlend / massenstrom ergibt den Termin, an dem abgeschaltet werden muss.
    Mit jedem neuen Messwert wird er neu gesetzt, dazwischen entscheidet die
    Uhr - der Schleifendurchlauf, der als erster näher als eine Schleifen-
    period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
2026-09-19 Verifizierung muss plausibel sein, Timeout ist ein Misserfolg
    Ein ruhiger Messwert allein ist noch keine Dosis: eine wieder abgestellte
    Tasse oder eine aufgelegte Hand liegt genauso ruhig. Die eingeschwungenen
    Messwerte müssen jetzt zusätzlich innerhalb von DOSE_PLAUSIBLE_GRAMS um
    das Zielgewicht liegen.
    Kommt in FINISHED_MAX_WAIT nichts Ruhiges und Plausibles zustande, war der
    Mahlvorgang kein Erfolg: bisher wurde genommen, was gerade da war, und die
    Totzeit danach kalibriert. Jetzt geht der Vorgang in den Fehlerzustand,
    ohne Eintrag in der Weight History, ohne Shot-Zähler und ohne
    Nachkalibrierung. "Dose off target" und "Scale unsteady" unterscheiden die
    beiden Fälle auf dem Display u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
2026-09-19 Ruheprüfung auf die Rohdaten, zwei Regeln für beides
    Die Toleranzprüfung lief auf dem gefilterten Signal, und das ist falsch
    herum: Filter v01 legt eine Gerade durch sein Fenster und liest sie am
    neuesten Messwert ab, liefert also auch dann einen glatten Wert, wenn die
    Messwerte darunter streuen. Eine Waage, die gar nicht ruht, bestand die
    Prüfung. Dafür gibt es jetzt rawData, denselben Ringpuffer mit den
    ungefilterten Messwerten. Der Filter sagt, was das Gewicht ist, die
    Rohdaten sagen, ob es sich bewegt.
    Die drei Toleranzpaare sind dabei zu zweien zusammengefasst, die Cup
    Detection und Verifizierung gemeinsam benutzen: zehn Messwerte innerhalb
    0,5 g oder zwanzig innerhalb 0,7 g. Auf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
    [config.hpp, scale.cpp, sim.cpp]
2026-09-20 Anzeige auch während der Toleranzprüfungen festhalten
    Die Hysterese von v03 verlangt für einen einzelnen Schritt bisher nur
    dann die Zustimmung von v02, wenn die Detektoren das Gewicht als flach
    erkannt haben. Dieselbe Ruhe braucht die Anzeige aber überall dort, wo
    gerade auf Toleranz geprüft wird: in der Tassenerkennung auf der leeren
    Waage und in der Verifizierung ab dem Moment, in dem die Messwerte für
    die Dosis zählen. Beide fragen, ob die Rohwerte innerhalb einer Toleranz
    beieinanderliegen - während das entschieden wird, soll die letzte Stelle
    nicht vom Rauschen bewegt werden.
    testingTolerance() beantwortet das aus dem Status, und die Bedingung
    lautet jetzt flach oder Toleranzp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
2026-09-20 Anzeige beim Mikrotarieren auf den Tassenwert setzen
    cupWeightEmpty rundet den Schnitt der Rohwerte, die die Tasse erkannt
    haben, und der Nullpunkt wird so verschoben, dass dieser Schritt die
    Wahrheit ist. Die Anzeige rundet dagegen den Wert von v01, und die
    Hysterese hält sie dort fest, wo sie steht - beide kommen also von
    verschiedenen Zahlen. In den sechs aufgezeichneten Mikrotaras lagen die
    Anzeige und der Tassenwert dreimal einen Schritt auseinander, der
    Mahlvorgang startete dann sichtbar bei 0,1 g oder -0,1 g statt bei 0,0.
    Die gemessene Dosis war nie betroffen, die rechnet mit dem gefilterten
    Wert gegen denselben verschobenen Nullpunkt.
    setShownV03() setzt die Anzeige deshalb auf cu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
2026-09-20 Die ältesten zwei Messwerte schwächer mitteln
    Ist ein Fenster als ruhig angenommen, sagt der Durchschnitt darüber, was
    das Gewicht ist: das Leergewicht der Tasse in der Tassenerkennung, die
    Dosis nach dem Mahlen. Dieses Fenster reicht bis an den Rand der ruhigen
    Strecke, und seine ältesten Messwerte tragen noch etwas von der Bewegung
    davor - die Tasse, die zur Ruhe kommt, die letzten Körner, die landen.
    Sie zählen deshalb schwächer: der älteste mit einem Drittel, der davor
    mit zwei Dritteln, alle übrigen voll. Das Gewicht eines Messwerts fadet
    damit linear über die ersten zwei ein, statt voll einzusetzen.
    MathBuffer bekommt dafür taperedAverageOfLast() für ein Fenster aus n
    Mess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
    [config.hpp, scale.cpp]
2026-09-20 Fortschrittsbalken als Skala mit Strichen zeichnen
    Statt Rahmen und gefüllter Box eine Linie über die volle Breite, der
    gemahlene Teil dicker, dazu Striche bei Start, Fortschritt und
    Sollgewicht.
2026-09-20 Fortschritt beim Mahlen durch Invertieren des Bildschirms zeigen
    Der Balken entfällt, stattdessen wird der Bildschirm von unten nach oben
    invertiert, bis zum Sollgewicht.
2026-09-20 Beim Verifizieren bis ganz nach oben invertieren
    Während des Mahlens bleibt eine Zeile frei, sobald die Mühle aus ist und
    nur noch der Messwert einschwingt läuft die Invertierung bis oben durch.
2026-09-20 Style-Menü mit der Darstellung des Mahl-Bildschirms
    Neuer Menüpunkt "Style" mit Exit und "Grinding Screen", dort wählt man
    zwischen dem Balken (Standard) und dem invertierten Bildschirm. Die Wahl
    wird in den Preferences gespeichert und beim Zurücksetzen auf den Balken
    gestellt.
2026-09-20 Mahl-Bildschirm mit wachsendem Rahmen als dritter Stil
    Vier Arme starten in der Mitte der oberen und unteren Kante, laufen nach
    außen zu den Ecken und von dort an den Seiten zurück zur Mitte, beim
    Sollgewicht ist der Rahmen geschlossen. Die Einstellung ist damit keine
    Ja/Nein-Frage mehr, sondern eine Liste von Stilen.
2026-09-20 Mahl-Bildschirm als Verlaufskurve
    Vierter Stil "Curve": statt Gewichten und Fortschrittsanzeige der ganze
    Mahlvorgang als Kurve, mit dem Sollgewicht als gestrichelter Linie, dem
    Abschaltpunkt und dem Nachlauf danach gepunktet. Unten Dauer, mittlerer
    Fluss und Abweichung vom Sollgewicht.
    Die Messwerte werden alle 100 ms mitgeschrieben und über die Breite
    gezogen, die Kurve zeigt also immer den ganzen Mahlvorgang. Ein Mahlgang,
    der länger ist als der Puffer, behält jeden zweiten Wert und schreibt von
    da an halb so oft mit.
2026-09-20 Verlaufskurve als Standard, Feinschliff an der Beschriftung
    Das Gewicht in der Tasse steht jetzt groß oben links, einen Pixel über
    der Linie des Sollgewichts, das daneben klein mitläuft. Die Fußzeile
    rückt eine Zeile hoch, damit die Unterlängen ganz dastehen, und der Fluss
    bekommt zwei Nachkommastellen.
2026-09-20 Rahmen statt Ladebalken beim Initialisieren
    Der Rahmen des Mahl-Bildschirms wird geteilt und wächst jetzt auch um den
    Startbildschirm, während die Waage bereit wird; geschlossen ist er, wenn
    es losgehen kann. Im Style-Menü steht darunter "Initializing" mit den
    beiden Stilen, der Rahmen ist die Voreinstellung.
2026-09-20 Drehendes Kreuz als dritter Startbildschirm
    Nur ein dünnes Kreuz durch die Mitte, das sich bis zur Bereitschaft der
    Waage eine Vierteldrehung im Uhrzeigersinn dreht. Seine Arme enden erst
    am Displayrand, werden also beim Drehen länger und wieder kürzer.
2026-09-20 Kreuz dreht schneller und steht am Ende still
    Die Vierteldrehung ist 0,2 s vor der Waage fertig, so lange steht das
    Kreuz aufrecht, bevor es weitergeht.
2026-09-20 Simulator wartet den Startbildschirm aus
    Seit der Startbildschirm feste BOOT_READY_MS steht, zeigten alle
    Screenshots nur die Tasse: die Sektionen sind kuerzer als die drei
    Sekunden. Eine Sektion, die den Bildschirm nicht selbst mit "boot"
    anfragt, wartet ihn jetzt vor ihrem ersten Befehl ab.
2026-09-20 Abweichung zum Ziel auf dem Finished-Screen
    Der Screen zeigt jetzt gross die Abweichung der Dosis vom Sollgewicht,
    darunter eine Skala mit dem Soll in der Mitte und darunter Dosis und
    Soll. Der Wert ist der Mittelwert der Rohmessungen ab dem Stillstands-
    Fenster, das die Dosis bestaetigt hat, und wird mit jeder Messung
    ruhiger.
    Die Skala reicht im feinsten Fall 0.2 g nach beiden Seiten und zieht
    sich fliessend auf, wenn die Abweichung mehr Platz braucht; die Striche
    behalten ihren Wert von 0.1 g, bis mehr als zehn davon auf eine Seite
    passen, danach stehen sie ein Gramm auseinander. Die Mahldauer faellt
    vom Screen weg.
2026-09-20 Plot der Abweichung waehrend der Verifizierung
    Zeichnet aus einem Log, was der Finished-Screen anzeigt: den Mittelwert
    der Rohmessungen ab der Abschaltmarke, minus Ziel plus Tasse, auf die
    zwei Nachkommastellen des Displays gerundet.
2026-09-20 Jede Aufnahme des Startbildschirms in ihrer eigenen Sektion
    Der Startbildschirm fuellt sich einmal ueber BOOT_READY_MS und steht
    danach still. Die vier Aufnahmen standen in einer Sektion, also lief
    jedes "boot" dort weiter, wo das vorherige aufgehoert hatte, und drei
    von ihnen zeigten denselben fertigen Rahmen. Jede bekommt jetzt ihre
    eigene Sektion und damit ihren eigenen Startbildschirm.
2026-09-20 Vorzeichen groesser setzen, Skalenstriche durchgehend
    Das Vorzeichen der Abweichung kommt aus einer Schrift eine Groesse
    ueber den Ziffern und steht knapp oberhalb ihrer Mitte statt auf der
    Grundlinie der Ziffern.
    Die Skala zeichnet alle Marken deckend statt im XOR: an der Mittel-
    marke, an den Enden und dort, wo Strich und Linie sich beruehren,
    fehlt damit kein Pixel mehr. Eine Marke, die der Balken ueberdeckt,
    geht einfach in ihm auf.
2026-09-20 Vorzeichen selbst zeichnen, mittig und symmetrisch
    Aus der Schrift kam das Plus schief: der Querbalken sass eine Zeile
    ueber der Mitte seines Strichs, drei Zeilen darueber und zwei darunter.
    Jetzt zeichnen zwei Kaesten das Zeichen, acht lang und zwei dick - beide
    Masse gerade, damit das Plus auf dem Pixelraster in beide Richtungen
    symmetrisch ist. Sein Balken liegt auf den Zeilen 9 und 10, also genau
    auf der Mitte der 16 Zeilen hohen Ziffern.
2026-09-20 Zweite Seite auf dem Finished-Screen mit den Details
    Am Knopf drehen blaettert auf dem Finished-Screen zwischen der
    Abweichung und einer zweiten Seite: Shot-Nummer, Mahldauer, das
    verifizierte Gewicht auf zwei Stellen und der Durchsatz in mg/s - die
    Dosis ueber die ganze Mahldauer, nicht der Massenstrom am Ende. Die
    naechste Leeranzeige setzt wieder auf die erste Seite zurueck.
2026-09-20 Skalenstriche unter dem Balken wieder invertieren
    Ein Strich, den der Balken ueberdeckt, war in ihm nicht mehr zu sehen.
    Er wird jetzt wieder invertiert, aber nur ueber die Zeilen des Balkens:
    die Linie darunter, die Mittelmarke, die Enden und jeder Strich neben
    dem Balken behalten jedes Pixel.
2026-09-20 Kerbe der Skalenstriche bis durch die Linie
    Unter dem Balken ist die duenne Linie dessen untere Kante, also geht
    die invertierte Kerbe eines Strichs jetzt bis durch sie hindurch.
    Neben dem Balken bleibt die Linie unberuehrt.
2026-09-20 Details zeigen die Werte, mit denen gerechnet wurde
    Dose ist jetzt die Dosis, mit der der Mahlvorgang bestaetigt wurde und
    aus der die Totzeit nachgefuehrt wird, nicht mehr der weiterlaufende
    Mittelwert der Rohmessungen. Flow ist der Massenstrom im Moment des
    Abschaltens - der Wert, mit dem die Firmware ausgerechnet hat, wann der
    Grinder aus muss. Beide stehen ab der Bestaetigung still.
2026-09-20 Dritte Seite auf dem Finished-Screen: die Totzeit
    Zeigt, mit welcher Totzeit der Mahlvorgang gestoppt wurde, welche seine
    Dosis gemessen hat und mit welcher der naechste gestoppt wird. Die
    gemessene steht auf "-", wenn der Massenstrom beim Abschalten zu klein
    war, um sie auszurechnen. Der Knopf blaettert jetzt durch drei Seiten.
2026-09-20 Totzeiten in ganzen Millisekunden
    Die Einheit steht in der Ueberschrift, die drei Werte sind ganze
    Millisekunden ohne Einheit und ohne Nachkommastelle.
2026-09-20 Dead Time heisst ueberall Delay
    Menuepunkt, Info-Menue, Weight History, Seite drei des Finished-Screens,
    die Felder der Grind-Logs (delay=, next_delay=) und alle Bezeichner und
    Konstanten im Code. Der Schluessel im Speicher bleibt "deadtime", damit
    eine Waage ihren schon kalibrierten Wert behaelt.
    In der Ueberschrift der Totzeit-Seite steht nur "Delay" fett, das
    "/ ms" daneben in der normalen Schrift.
2026-09-20 Plot der Abschaltrechnung neben dem Verlauf der Abweichung
    plotverify zeichnet pro Log ein zweites Bild: die Rohmessungen um das
    Abschalten herum, die Gerade, auf der die Firmware abgeschaltet hat
    (Flow und Dosis aus der Abschaltmarke), dieselbe Gerade noch einmal auf
    den Rohmessungen der letzten vier Sekunden, und das Gewicht, mit dem
    die Dosis verifiziert wurde. Wo die gestrichelte Verlaengerung die
    Waagerechte trifft, liegt die gemessene Verzoegerung.
    Das Ziel kommt jetzt aus dem Mikrotara-Wert des Logs, wenn die
    Abschaltmarke es nicht nennt - ohne das lag die Abweichungskurve
    neuerer Aufnahmen um das Tassengewicht daneben.
2026-09-20 Abschaltgerade, Dosis und Anzeige auf den Rohdaten
    Die Gerade, aus der Abschaltzeitpunkt, Massenstrom und der Bezugswert
    fuer den Delay kommen, laeuft jetzt ueber die Rohmessungen statt ueber
    die gefilterten Gewichte: der Filter legt eine eigene Gerade und hinkt
    einem steigenden Gewicht nach, und dieser Nachlauf ging vorher voll in
    Fluss und Delay ein.
    Die Dosis kommt ebenso aus den Rohdaten - als Mittel ueber genau das
    Ruhefenster, das die Toleranzpruefung bestanden hat, die beiden
    aeltesten Messwerte schwaecher gewichtet. Damit ist die erste
    verwendete Messung automatisch die erste nach Grinder-aus plus Delay.
    Das feste Fenster von einer Sekunde ueber die gefilterten Gewichte
    faellt weg.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
2026-09-20 Gemessenen Delay ungekuerzt behalten
    Der aus dem Shot berechnete Delay wird nicht mehr vor dem Anzeigen auf
    0 bis 2 s begrenzt, sondern so gezeigt, wie er herauskommt - auch
    negativ. Das heisst, beim Abschalten stand mehr auf der Waage als am
    Ende, und genau das will man beim Suchen sehen. Begrenzt wird nur noch
    der Wert, mit dem nachgefuehrt wird. "Nicht messbar" ist jetzt NAN
    statt 0, sonst waere es von einem gemessenen Null nicht zu
    unterscheiden.
2026-09-20 Verlauf und Fluss als vierte und fuenfte Detailseite
    Der Knopf blaettert auf dem Finished-Screen jetzt durch fuenf Seiten:
    hinter den Zahlen kommen der Verlauf des Gewichts ueber den ganzen
    Mahlvorgang und der Fluss, also die Steigung derselben Kurve, ueber
    etwa eine Sekunde gemittelt. Beide ueber den ganzen Bildschirm, ohne
    Zahlen am Rand; auf der Flussseite steht nur der Kopf der Skala.
    Aufgezeichnet wird die Kurve dafuer in jedem Stil des Mahl-Bildschirms
    und aus dem gefilterten statt dem angezeigten Gewicht, dessen Stufen
    sich im Fluss als Zacken zeigen wuerden.
2026-09-20 Plots: eigene Ordner, dunkle Flaeche, Abschaltdiagramm
    plotverify schreibt nach logs/plots/verify und logs/plots/delay,
    plotgrind nach logs/plots/filter; die Dateien heissen wie das Log.
    Dunkel ist die Voreinstellung, --light zeichnet hell.
    Das Abschaltdiagramm zeigt die Gerade der Firmware und dieselbe auf den
    Rohmessungen, die gefilterte Treppe samt Sprung auf den verifizierten
    Wert, Ziel und verifiziertes Gewicht sowie beide Delays; jede Wertereihe
    und ihre Ausgleichsgerade teilen sich einen Farbton.
2026-09-20 Gemittelte Abweichung faengt bei einem neuen Gewicht neu an
    Der Mittelwert hinter der Abweichung wird mit jeder Messung ruhiger, so
    ruhig, dass eine Hand am Becher nach ein paar Sekunden kaum noch etwas
    bewegt haette. Fuenf Messungen in Folge weiter als drei Sigma vom
    laufenden Mittel gelten deshalb als neues Gewicht: der Mittelwert wird
    verworfen und beginnt mit der ersten dieser fuenf. Kuerzere Ausreisser
    gehen weder ein noch setzen sie etwas zurueck.
2026-09-20 Calibrate-Untermenue fuer Waage und Grinder
    Cup Weight 1, Cup Weight 2, Scale Factor und Delay stehen nicht mehr
    im Hauptmenue, sondern in einem eigenen Untermenue "Calibrate" mit
    eigenem Exit. Das Hauptmenue ist damit halb so lang, und was man
    einmal einstellt und dann liegen laesst, steht beieinander. Das
    Speichern einer dieser Einstellungen fuehrt in das Untermenue zurueck,
    nicht ins Hauptmenue.
2026-09-20 Sleep Timer nur noch ueber eine Zeile im Code im Menue
    Der Eintrag ist voreingestellt aus, SLEEP_TIMER_MENU in config.hpp
    holt ihn zurueck. Der Timer selbst laeuft unveraendert weiter.
    Dafuer wird das Menue jetzt aus einer Liste aller Eintraege gebaut,
    und der Klick entscheidet nach der Kennung des Eintrags statt nach
    seiner Position - sonst haette jeder verborgene Eintrag die Nummern
    aller folgenden verschoben. Das Debug-Menue haengt an derselben Stelle.
2026-09-20 Abschaltdiagramm als Detailseite, Diagramme vor die Zahlen
    Die Seiten des Finished-Screens zeigen jetzt erst die drei Bilder des
    Mahlvorgangs und dann seine Zahlen: Abweichung, Verlauf, Abschaltung,
    Fluss, die Daten des Shots und zuletzt die Delay-Werte.
    Neu darin ist die Abschaltung: die Rohmessungen von fuenf Werten vor dem
    Ausschalten des Grinders bis drei Werte nach dem Bestaetigen der Dosis,
    mit der Geraden, auf der die Firmware abgeschaltet hat, dem Zielgewicht
    und der verifizierten Dosis. Das ist der Ausschnitt, aus dem das Delay
    gelesen wird, wie ihn tools/plotverify.py aus den Logs zeichnet, nur eng
    geschnitten. Aufgezeichnet wird jede einzelne Rohmessung des Samplers,
    nicht der ge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
2026-09-20 Noise-Messung im Calibrate-Menue
    Der neue Eintrag "Noise" misst, wie weit eine einzelne Messung dieser
    Waage streut. Die Rohmessungen der ruhenden Waage werden gesammelt und
    als Verteilung ihres Abstands vom eigenen Mittelwert gezeichnet: eine
    Saeule je Band dieses Abstands, so hoch wie die Zahl der Messungen
    darin. Eine Wagezelle streut normal, es waechst also eine Glocke, und
    das Sigma darueber ist ihre Breite.
    Die ersten 20 Sekunden steht an der Stelle des Sigmas ein Balken: was
    die ersten Messungen ueber die Streuung sagen, sagt mehr ueber ihre
    geringe Zahl als ueber die Waage. Ist er voll, verschwindet er, das
    Sigma tritt an seine Stelle, und weiter gesammelt wird trotzdem - jede
    weite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
    [config.hpp, display.cpp, display.hpp, rotary.cpp, scale.cpp, sim.cpp]
2026-09-20 Messpunkte im Abschaltdiagramm als kleine Kreuze
    Die Rohmessungen auf der Delay-Detailseite waren einzelne Pixel und
    gingen zwischen der gestrichelten Zielgeraden, der Abschaltgeraden und
    den beiden Senkrechten unter. Jede Messung bekommt jetzt zusaetzlich ein
    Pixel links, rechts, oben und unten, steht also als kleines Kreuz.
    Arme, die aus der Zeichnung laufen wuerden, bleiben weg: am linken und
    rechten Rand und an den Zeilen, in denen die Messungen gezeichnet
    werden.
